julkah/nerdbot/README.md

# Bohlebots Nerdbot

This repository contains the last version of all files of the Nerdbot, a robot build in school with the team "Bohlebots" (bohlebots.de). It was built to participate at Robocup tournament in the 2v2 Soccer Open League. A documentation is enclosed as .pdf in German.
