julkah/nerdbot/eagle/Philip_Neill_Schaltung_kicker/Philip_Neill_Schaltung.brd

## EAGLE design eagle/Philip_Neill_Schaltung_kicker/Philip_Neill_Schaltung.brd (2019-11-05)

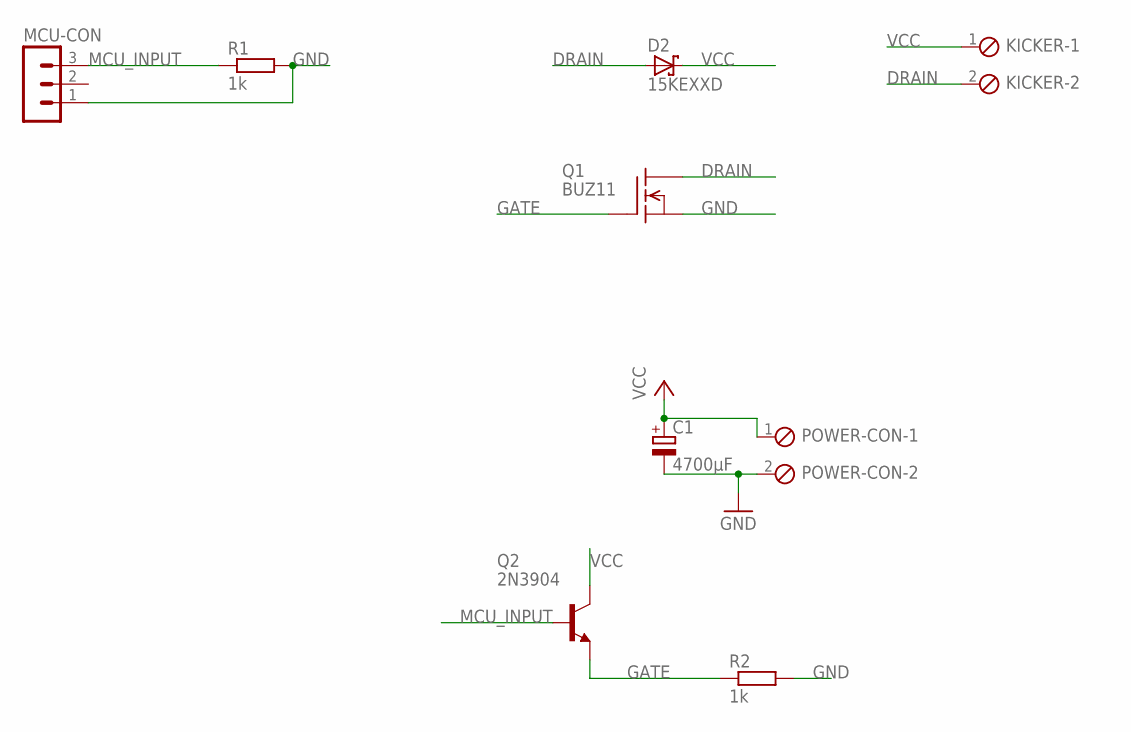
[picture p4: schematic Philip_Neill_Schaltung.sch]

Parts:
C1: 4700µF; EB20D
D2: 15KEXXD; DO201T15
KICKER: MPT2; 2POL254
MCU-CON: MA03-1
POWER-CON: MPT2; 2POL254
Q1: BUZ11; TO220
Q2: 2N3904; TO92
R1, R2: 1k; 0207/7

Connections:
DRAIN: D2.A, KICKER.2, Q1.2 (D)
GATE: Q1.1 (G), Q2.3 (E), R2.1
GND: C1.-, MCU-CON.1, POWER-CON.2, Q1.3 (S), R1.2, R2.2
MCU_INPUT: MCU-CON.3, Q2.2 (B), R1.1
VCC: C1.+, D2.C, KICKER.1, POWER-CON.1, Q2.1 (C)

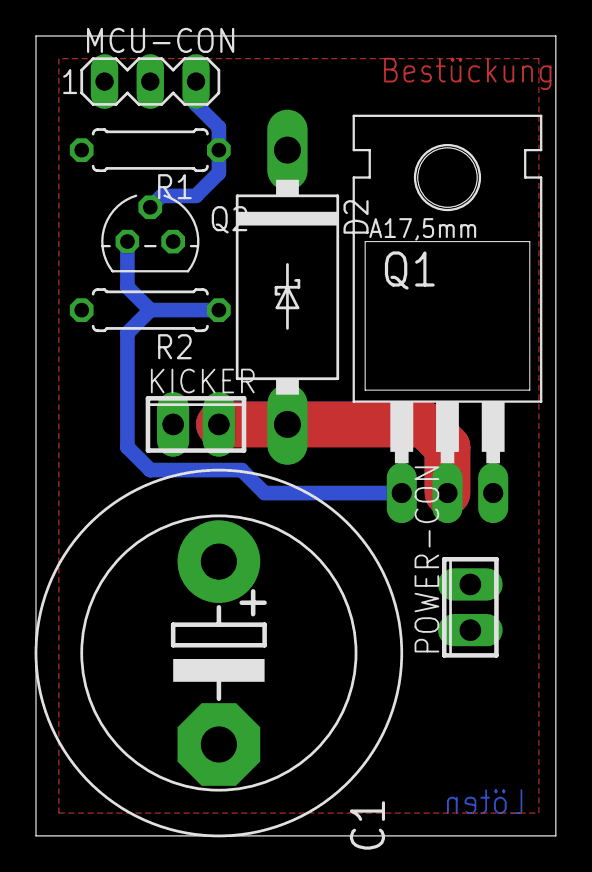
[picture p5: board Philip_Neill_Schaltung.brd from above]

Board: 2 copper layers, 28.9 x 44.4 mm, 9 parts (0 on the bottom side), 5 nets.
