julkah/nerdbot/eagle/odroid_platine_nerdbot/odroid_platine_nerdbot.brd

## EAGLE design eagle/odroid_platine_nerdbot/odroid_platine_nerdbot.brd (2019-11-05)

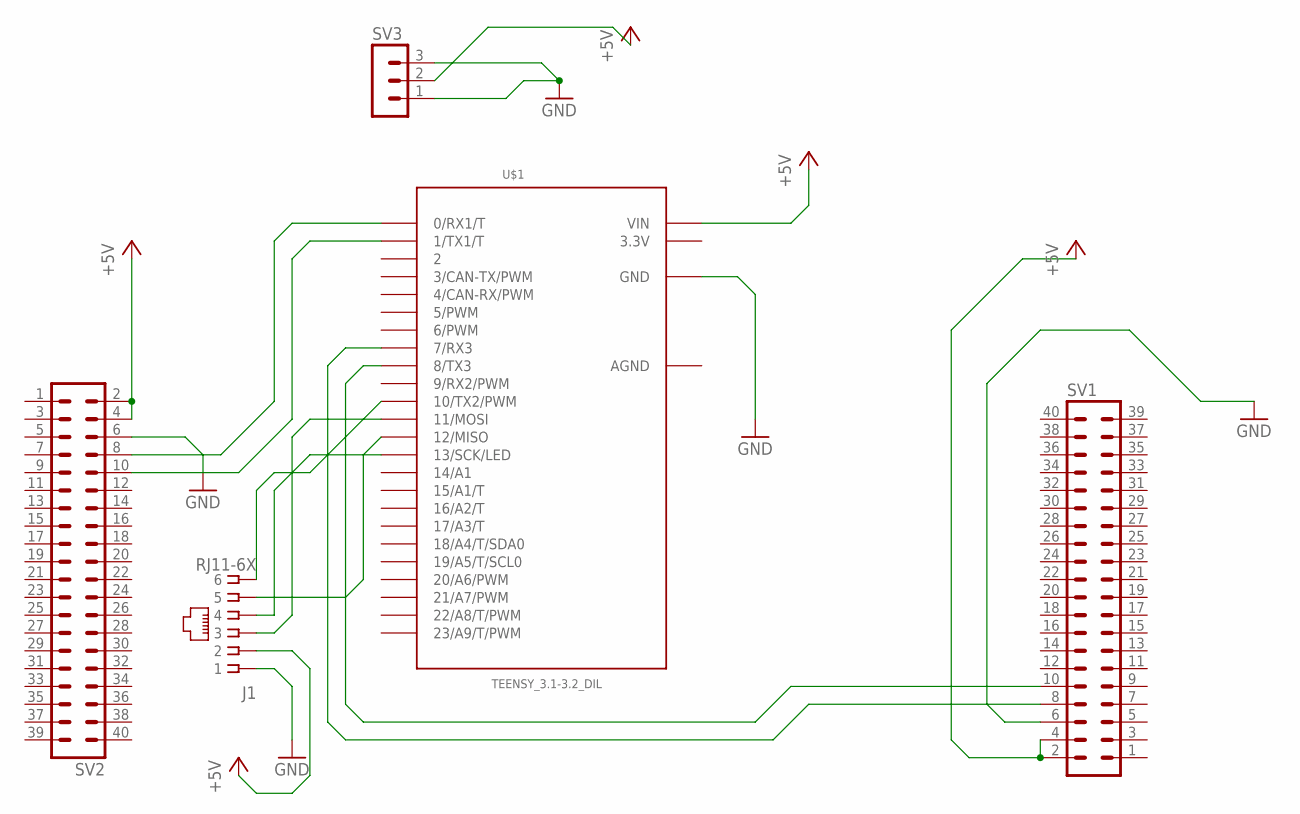
[picture p6: schematic odroid_platine_nerdbot.sch]

Parts:
J1: RJ11-6X; RJ11-NO_SHIELD
SV1, SV2: MA20-2
SV3: MA03-1
U$1: TEENSY_3.1-3.2_DIL; TEENSY_3.0-3.2&LC_DIL

Connections:
3.3V: U$1.3.3V
+5V: J1.2, SV1.2, SV1.4, SV2.2, SV2.4, SV3.2, U$1.VIN
AGND: U$1.AGND
GND: J1.1, SV1.6, SV2.6, SV3.1, SV3.3, U$1.GND
unnamed: SV2.8, U$1.0 (0/RX1/T)
unnamed: SV2.10, U$1.1 (1/TX1/T)
unnamed: SV1.8, U$1.7 (7/RX3)
unnamed: SV1.10, U$1.8 (8/TX3)
unnamed: J1.3, U$1.11 (11/MOSI)
unnamed: J1.4, U$1.13 (13/SCK/LED)
unnamed: J1.5, U$1.12 (12/MISO)
unnamed: J1.6, U$1.10 (10/TX2/PWM)

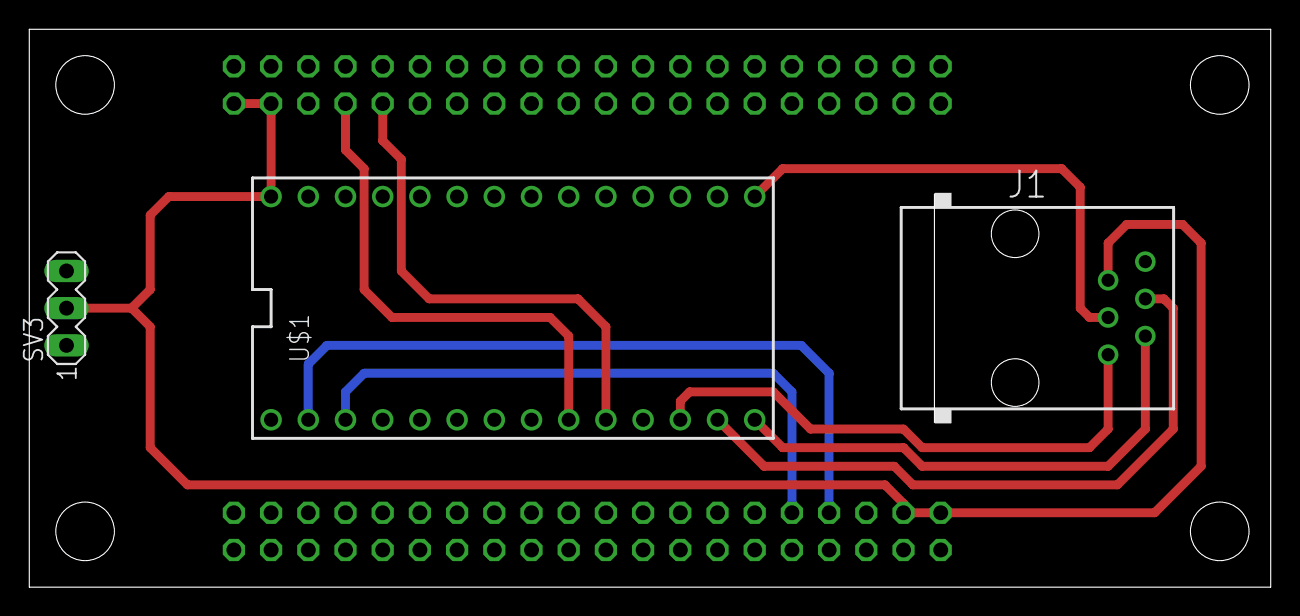
[picture p7: board odroid_platine_nerdbot.brd from above]

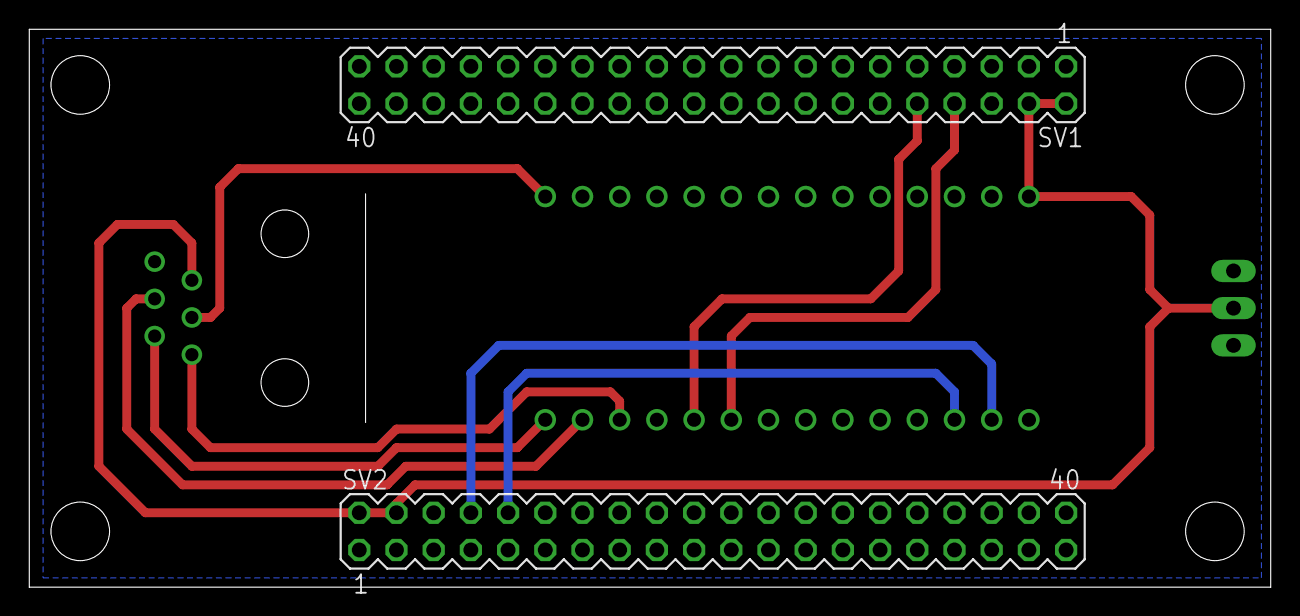
[picture p8: board odroid_platine_nerdbot.brd from below]

Board: 2 copper layers, 84.8 x 38.1 mm, 5 parts (2 on the bottom side), 10 nets.
